trustlessalice/camboard/datasheets/ov5640-camera-diagram.jpg

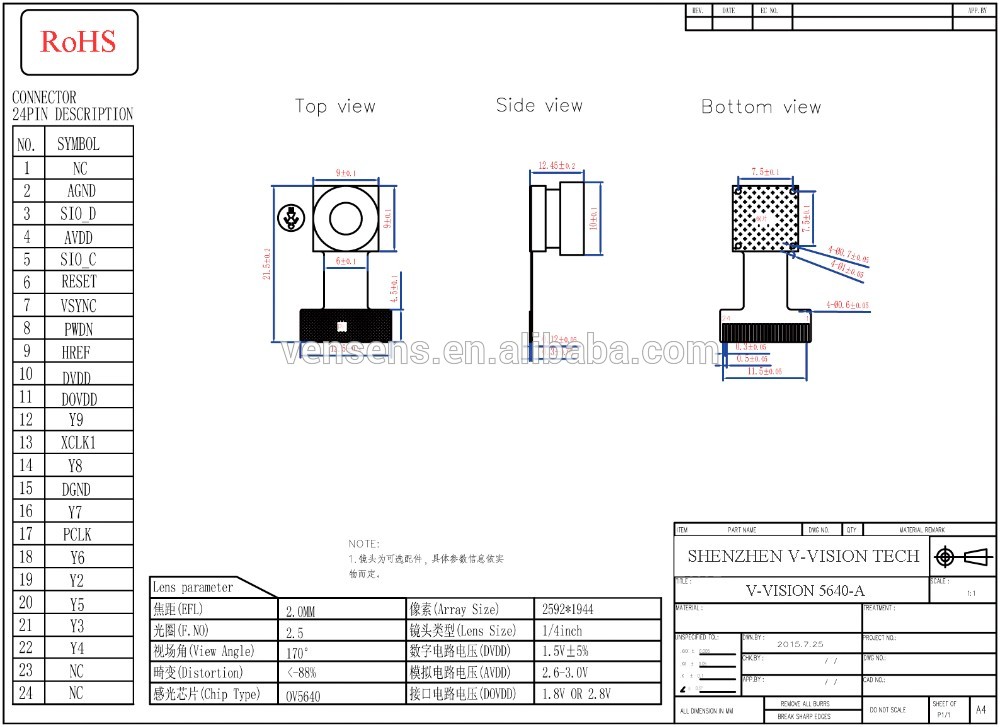
datasheets/ov5640-camera-diagram.jpg
