trustlessalice/camboard/custom-components/3d-models/keystone-PN1022.STEP

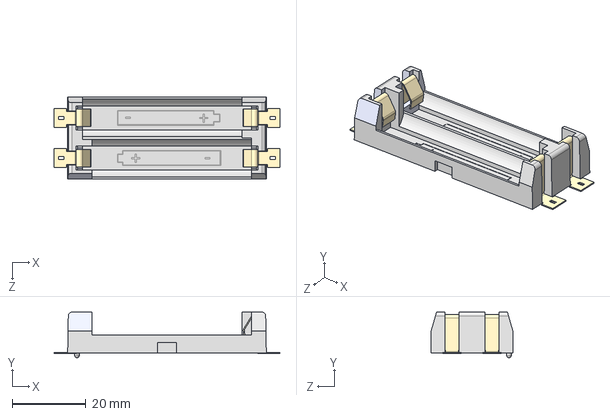
[picture p3: CAD file, 2019-03-20]
custom-components/3d-models/keystone-PN1022.STEP
61.5 x 12.4 x 22.2 mm
