trustlessalice/camboard/custom-components/3d-models/battery-AAA.step

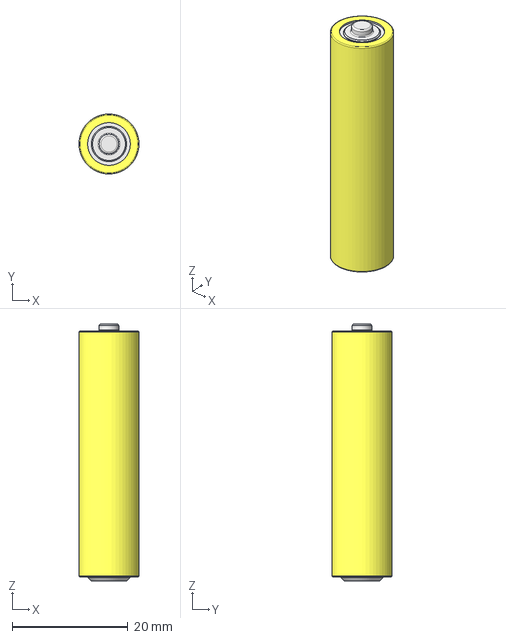
[picture p4: CAD file, 2019-03-20]
custom-components/3d-models/battery-AAA.step
10.4 x 10.4 x 44.5 mm
