trustlessalice/camboard/(commit log)

2019-02-21 Kinetis MK82 template schematic
    [camboard.kicad_pcb, camboard.sch]
2019-03-02 Schematic capture complete
    [camboard.sch]
2019-03-03 Add serial port and USB connectors
    [camboard.sch]
2019-03-20 Layout complete
    [FH12-50S-0.5SH.stp, battery-AAA.step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]
2019-03-30 Update switch MPN
    [camboard.sch]
2019-03-30 Update 4.7uF MPN
    [camboard.sch]
2019-03-31 Update MPN for reset button
    [camboard.sch]
2019-03-31 Power LCD backlight from VREG_IN, instead of 3.3 rail
    [camboard.kicad_pcb, camboard.sch]
